bropple/WMRLC-Wireless-Model-Rocket-Launch-Controller-Rev2/img/Label/WirelessModelRocketLaunchController.png

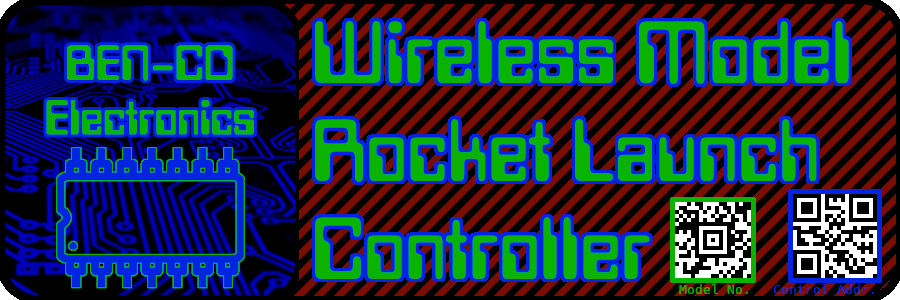
img/Label/WirelessModelRocketLaunchController.png
