bropple/WMRLC-Wireless-Model-Rocket-Launch-Controller-Rev2/Resources/BOM.xlsx

Item Description | Schematic Designation(s) | Purpose | Manufacturer | Manufacturer Product Number | Supplier | Supplier Item Number / Link | Quantity | Price/Unit | Total | Notes
RELAY GEN PURPOSE SPDT 16A 5V | K1 | Ignition Relay | Panasonic Electric Works | ALZ11B05W | Digi-Key | ALZ11B05W-ND | 1 | $2.83 | $2.83
SWITCH ROCKER SPST 16A 125V | SW2 | Ignition Safety Switch | CW Industries | GRS-4011-0068 | Digi-Key | SW322-ND | 1 | $1.06 | $1.06
SWITCH ROCKER SPST 10A 125V | SW1 | System Power Switch | E-Switch | RA11131123 | Digi-Key | EG5618-ND | 1 | $0.57 | $0.57
IC ADC 16BIT SIGMA-DELTA 8SOIC | U2 | I2C A/D Converter - 16 bit | Microchip Technology | MCP3426A2-E/SN | Digi-Key | MCP3426A2-E/SN-ND | 1 | $2.61 | $2.61
DIODE GEN PURP 400V 1A DO41 | D2 | Relay Flyback Diode | ON Semiconductor | 1N4004G | Digi-Key | 1N4004GOS-ND | 1 | $0.21 | $0.21
DIODE GEN PURP 650V 40A TO220-2 | D1 | Separate VDIV- node from GND for measurement | Infineon Technologies | IDP20E65D2XKSA1 | Digi-Key | IDP20E65D2XKSA1-ND | 1 | $1.67 | $1.67
TRANS NPN 40V 0.2A TO-92 | Q1 | Turn relay on and off | ON Semiconductor | 2N3904BU | Digi-Key | 2N3904FS-ND | 1 | $0.20 | $0.20
RES 1K OHM 1/4W 1% AXIAL | R1, R2 | Current limiting for measurement and BJT base | Stackpole Electronics Inc | RNF14FTD1K00 | Digi-Key | RNF14FTD1K00CT-ND | 2 | $0.10 | $0.20
RES 4.02K OHM 1/4W 1% AXIAL | R6, R8 | Voltage Division | Stackpole Electronics Inc | RNF14FTD4K02 | Digi-Key | RNF14FTD4K02CT-ND | 2 | $0.10 | $0.20
RES 5.6K OHM 1/4W 1% AXIAL | R3, R4 | I2C Pullups to 3v3 | Stackpole Electronics Inc | RNMF14FTC5K60 | Digi-Key | S5.6KCACT-ND | 2 | $0.10 | $0.20
RES 15K OHM 1/4W 1% AXIAL | R10 | Votlage Division | Stackpole Electronics Inc | RNF14FTD15K0 | Digi-Key | RNF14FTD15K0CT-ND | 1 | $0.10 | $0.10
RES 24K OHM 1/4W 1% AXIAL | R12 | Voltage Division | Stackpole Electronics Inc | RNMF14FTC24K0 | Digi-Key | S24KCACT-ND | 1 | $0.10 | $0.10
RES 26.1K OHM 1/4W 1% AXIAL | R5, R7 | Voltage Division | Yageo | MFR-25FBF52-26K1 | Digi-Key | 26.1KXBK-ND | 2 | $0.10 | $0.20
RES 100K OHM 1/4W 1% AXIAL | R9, R11 | Voltage Division | Stackpole Electronics Inc | RNF14FTD100K | Digi-Key | RNF14FTD100KCT-ND | 2 | $0.10 | $0.20
CAP CER 0.1UF 50V X7R RADIAL | C1 | Bypass capacitor | Vishay Beyschlag/Draloric/BC Components | K104K15X7RF5TL2 | Digi-Key | BC1084CT-ND | 1 | $0.23 | $0.23
CAP TANT 10UF 10% 16V RADIAL | C2 | Bulk capacitor | AVX Corporation | TAP106K016CCS | Digi-Key | 478-4169-ND | 1 | $0.65 | $0.65
TERMINAL BLOCK, SCREW TYPE, 5.00 | J2, J3 | Terminal block - for attaching alligator clips | CUI Devices | TB001-500-02BE | Digi-Key | 102-6134-ND | 2* | $0.59 | $1.18 | Available in bulk from Amazon, or you could use a different connector.
SOCKET ADAPTER SOIC TO 8DIP | N/A | Needed to use the I2C ADC on a solder board | Aries Electronics | LCQT-SOIC8-8 | Digi-Key | A880AR-ND | 1* | $2.57 | $2.57 | Available in bulk from Amazon
LITHIUM ION 18650 BATTERY - 3.7V | N/A | 3.7V rechargeable Li-ion battery | TinyCircuits | ASR00050 | Digi-Key | 1832-1050-ND | 1* | $5.95 | $5.95
CONN RCPT 16POS 0.1 GOLD PCB | N/A | Pin header for NodeMCU - makes it removable | TE Connectivity AMP Connectors | 1-215297-6 | Digi-Key | A106615-ND | 2* | $2.08 | $4.16 | Not strictly necessary if using a larger solder board. Bulk amazon packs might be better
Non-DigiKey Items
NodeMCU Lolin V3 | U1 | Wi-Fi Enabled Microcontroller | Varies | N/A | Amazon | https://www.amazon.com/HiLetgo-Internet-Development-Wireless-Micropython/dp/B081CSJV2V?rnid=2470954011&rps=1 | 3* | $4.66 | $13.99 | Price varies. Packs are usually cheaper.
Solder Board | N/A | Holds the circuit together | Varies | N/A | Amazon | https://www.amazon.com/Teenitor-Prototype-Project-Quality-Universal/dp/B01IONQQ3Y?rnid=2470954011&rps=1 | 24* | $0.37 | $8.99 | Can be different sizes, minimum 5x7cm recommended
18650 Battery shield | BAT_1 | Charging circuit and boost converter for 18650 li-ion | Varies | N/A | Amazon | https://www.amazon.com/Ximimark-Battery-Expansion-Development-Raspberry/dp/B07K7GZ2RK?rnid=2470954011&rps=1 | 2* | $4.99 | $9.99 | Could also use buck/boost converters with different batteries
 |  |  |  |  |  |  |  | Grand Total | 58.06 | Does not include enclosure or launch battery.
