bropple/WMRLC-Wireless-Model-Rocket-Launch-Controller-Rev2/Resources/Schematic.pdf

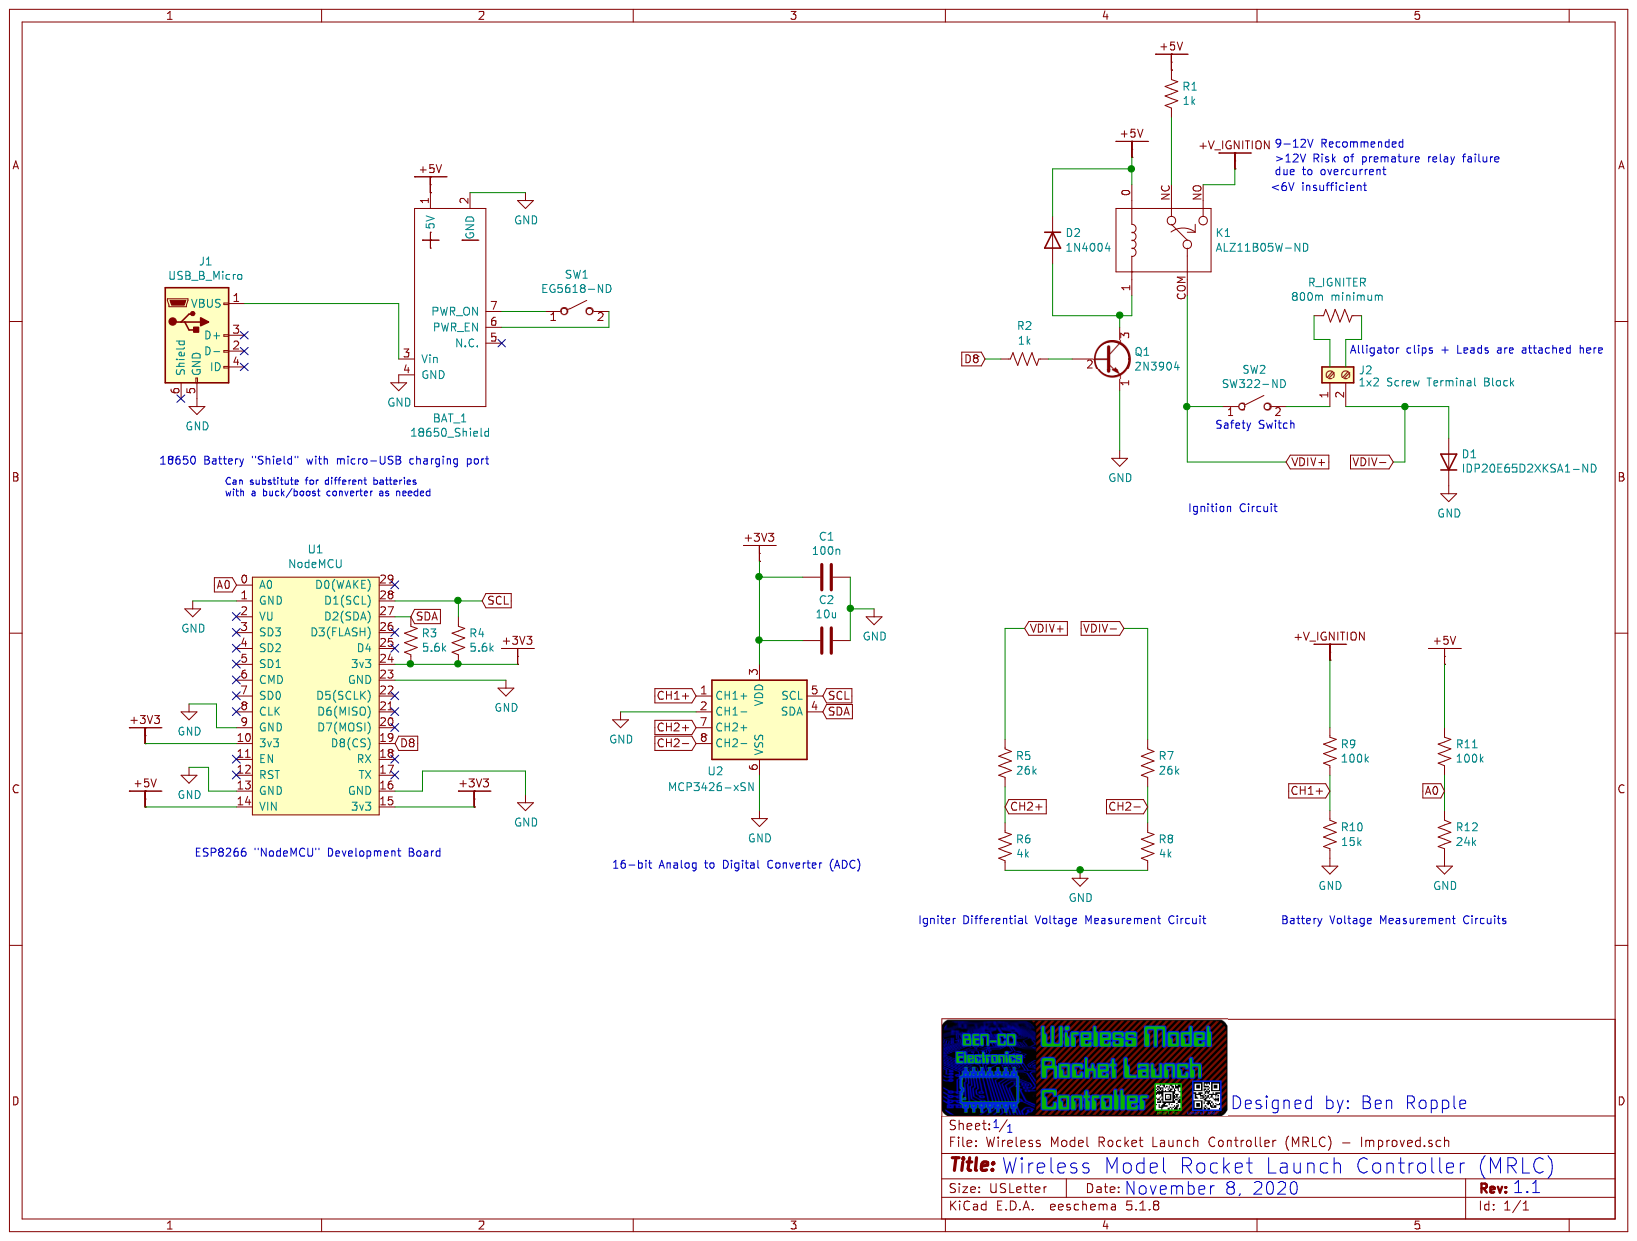
[picture p10: page 1]
