bropple/WMRLC-Wireless-Model-Rocket-Launch-Controller-Rev2/(commit log)

2020-11-12 First upload to public repo
    [BOM.xlsx]
2020-11-12 Update WirelessRocketLaunchCtrlr-Rev2.ino
    fixed spelling errors
    [WirelessRocketLaunchCtrlr-Rev2.ino]
2020-11-12 Minor correction to BOM
    [BOM.xlsx]
